jmccall32/PoorMansPMM/EAGLE/PMM/PMM.brd

## EAGLE design EAGLE/PMM/PMM.brd (2021-03-14)

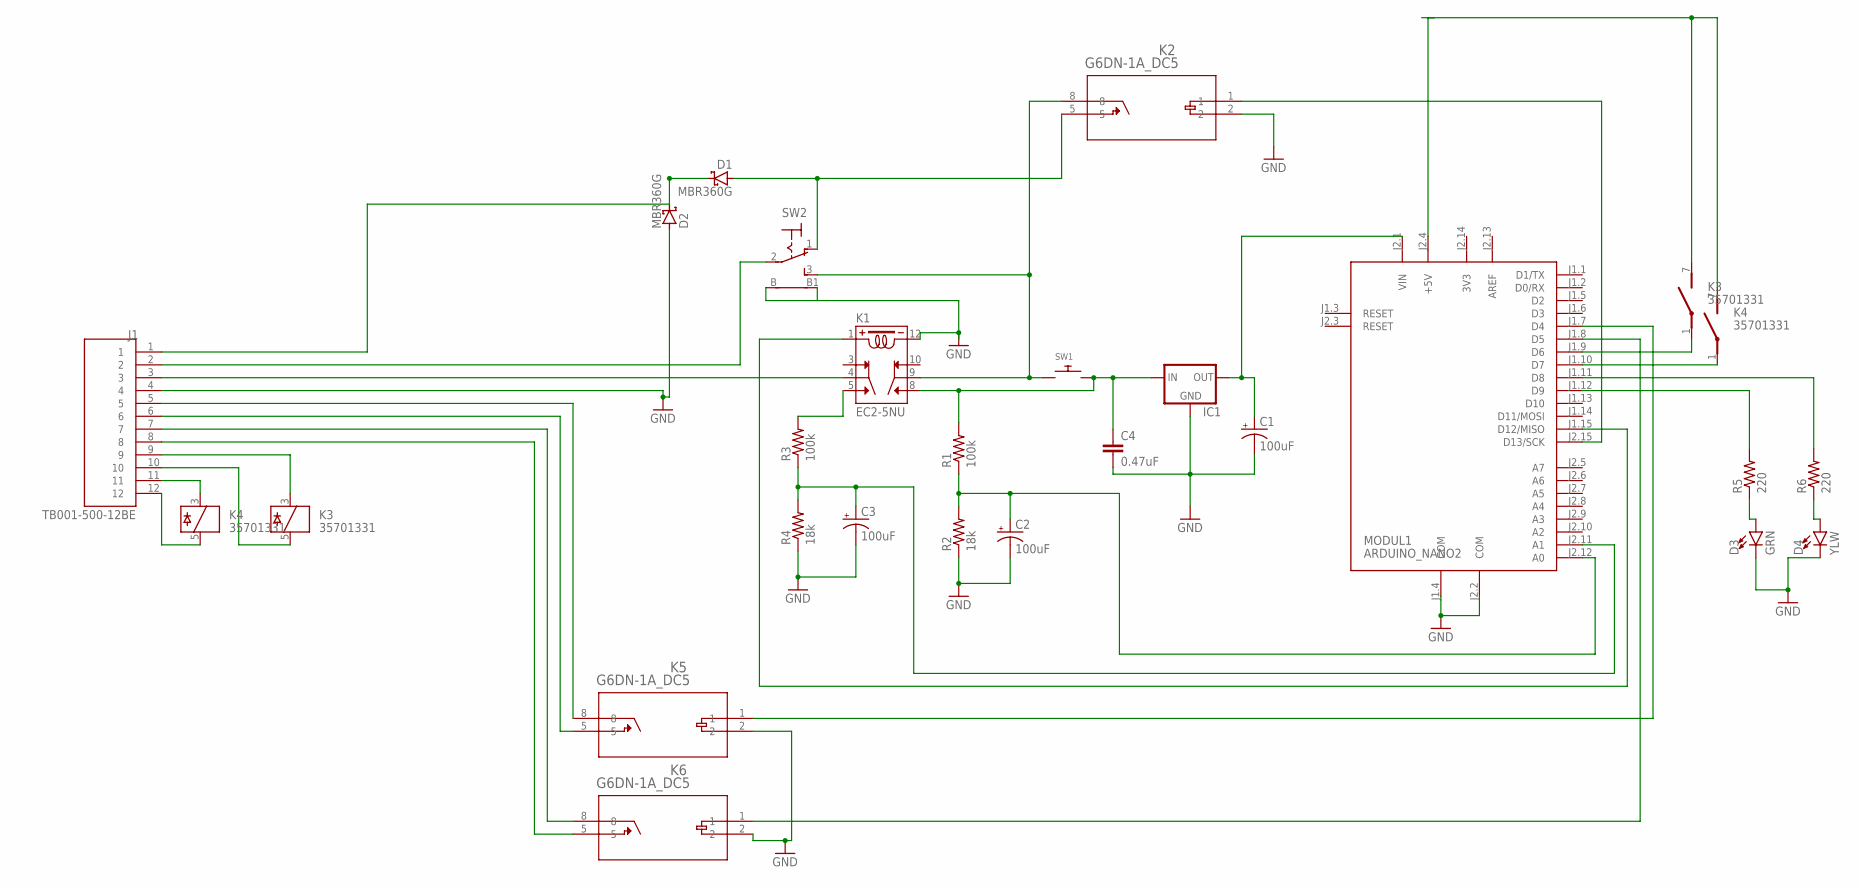
[picture p1: schematic PMM.sch]

Parts:
C1, C2, C3: 100uF; E2,5-7
C4: 0.47uF; C10B6
D1, D2: MBR360G; DO201AD
D3: GRN; LED_5MM-KIT
D4: YLW; LED_5MM-KIT
IC1: 78XXS
J1: TB001-500-12BE; CUI_TB001-500-12BE
K1: EC2-5NU; RELAY_EC2-5NU
K2, K5, K6: G6DN-1A_DC5; RELAY_G6DN-1A_OMR
K3, K4: 35701331; REED
MODUL1: ARDUINO_NANO2
R1, R3: 100k; 0207/12
R2, R4: 18k; 0207/12
R5, R6: 220; 0207/12
SW1: SWITCH_PUSHBUTTONON-MOM.2; TACT_PANA-EVQ
SW2: M20130M2013S2A2W30; M201*30

Connections:
3V3: MODUL1.J2.14 (3V3)
AREF: MODUL1.J2.13 (AREF)
GND: C1.-, C2.-, C3.-, C4.2, D2.A, D3.K (C), D4.K (C), IC1.GND, J1.4, K1.12, K2.2, K5.2, K6.2, MODUL1.J1.4 (COM), MODUL1.J2.2 (COM), R2.1, R4.1, SW2.B, SW2.B1
unnamed: J1.2, SW2.2
unnamed: D1.A, K2.5, SW2.1 (O)
unnamed: K1.9, K2.8, SW1.P$1, SW2.3 (S)
unnamed: C4.1, IC1.IN, K1.8, R1.2, SW1.P$2
unnamed: K2.1, MODUL1.J2.15 (D13/SCK)
unnamed: D4.A, R6.1
unnamed: J1.3, K1.4
unnamed: C2.+, MODUL1.J2.12 (A0), R1.1, R2.2
unnamed: D1.C, D2.C, J1.1
unnamed: C1.+, IC1.OUT, MODUL1.J2.1 (VIN)
unnamed: C3.+, MODUL1.J2.11 (A1), R3.1, R4.2
unnamed: K1.5, R3.2
unnamed: K3.7 (S), K4.7 (S), MODUL1.J2.4 (+5V)
unnamed: J1.9, K3.3
unnamed: J1.12, K4.5
unnamed: J1.10, K3.5
unnamed: K6.1, MODUL1.J1.8 (D5)
unnamed: K5.1, MODUL1.J1.7 (D4)
unnamed: K3.1, MODUL1.J1.9 (D6)
unnamed: J1.11, K4.3
unnamed: K4.1, MODUL1.J1.10 (D7)
unnamed: K1.1, MODUL1.J1.15 (D12/MISO)
unnamed: D3.A, R5.1
unnamed: MODUL1.J1.11 (D8), R6.2
unnamed: MODUL1.J1.12 (D9), R5.2
unnamed: J1.5, K5.8
unnamed: J1.6, K5.5
unnamed: J1.7, K6.8
unnamed: J1.8, K6.5

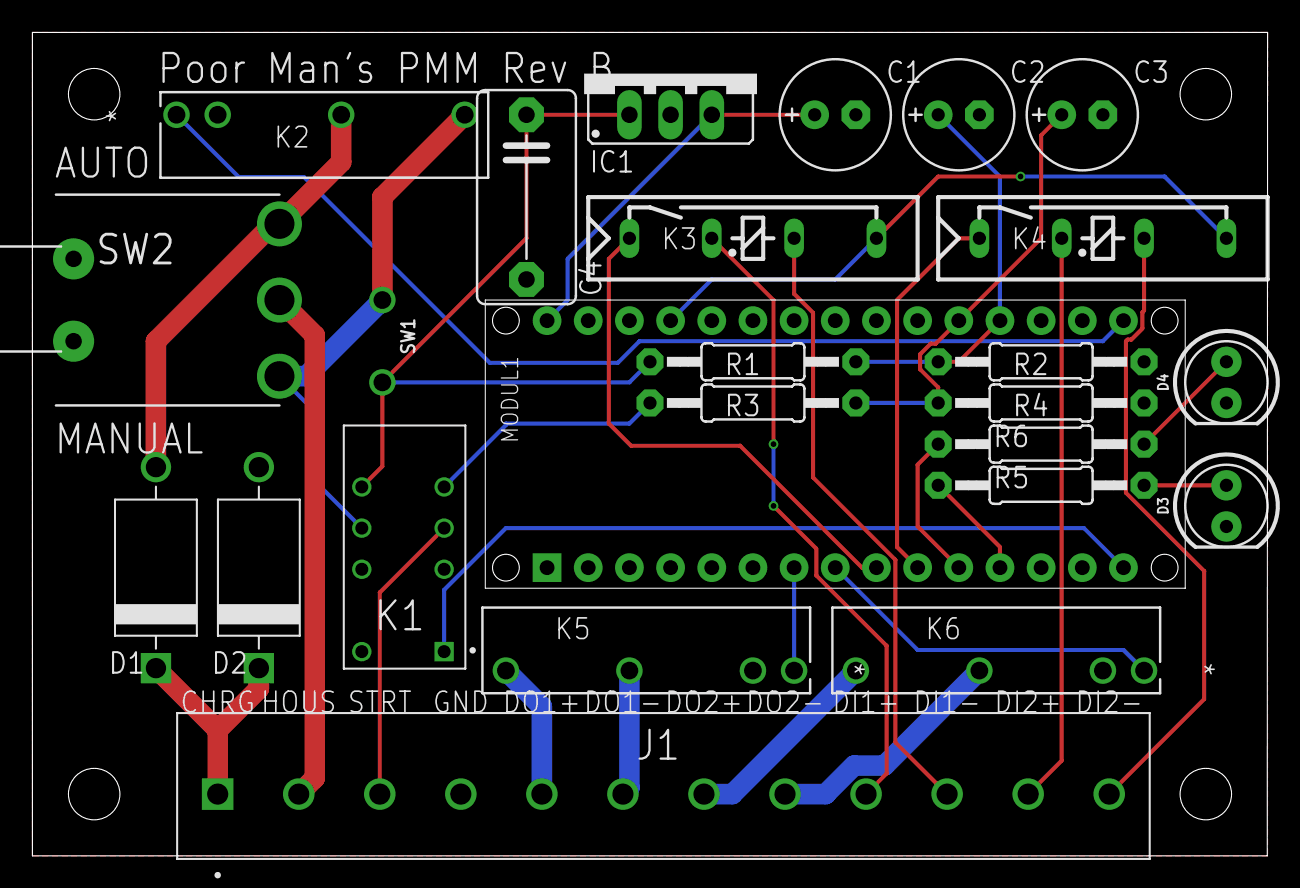
[picture p2: board PMM.brd from above]

Board: 2 copper layers, 76.2 x 50.8 mm, 25 parts (0 on the bottom side), 30 nets.
