jmccall32/PoorMansPMM/(commit log)

2021-01-27 Added eagle pcb & scr files
    [PMM.brd, PMM.sch]
2021-01-27 Arduino IDE changed directory names
2021-01-28 Minor format fixes
    [PMM.brd, PMM.sch]
2021-02-22 Updated C4 value
    [PMM.brd, PMM.sch]
2021-02-27 Added range checking for EEPROM loading and indicator LED outputs
2021-03-11 Switched D12 & D13 to have on-board indicator for on state
    [PMM.brd, PMM.sch]
2021-03-11 Corrected SW2 footprint
    [PMM.brd, PMM.sch]
2021-03-11 Added indicator LEDs
    [PMM.brd, PMM.sch]
2021-03-11 Indicator LEDs moved to correct channels
    [PoorMansPMMWithSerialMonitor.ino]
2021-03-12 Rotated LEDs to bring pads in from board edge
    [PMM.brd]
2021-03-14 Changed spare DIO to 2 in, 2 out, all relay isolated
    [PMM.brd, PMM.sch]
2022-02-25 Changed logic to prioritize cross-charging from house to start even when house is not actively being charged
2022-02-27 Changed cross-charging logic to prioritize charging start battery from house battery, even when house battery is not being actively charged
