jmccall32/PoorMansPMM/(notices)

Notices in the files:
parts and their libraries:
G6DN: COPYRIGHT: Copyright (C) 2018 Accelerated Designs. All rights reserved
SparkFun-LED: Licensing: Creative Commons ShareAlike 4.0 International - https://creativecommons.org/licenses/by-sa/4.0
